yzytz17/1.5-joint-module/mechanical/cad-solidworks/universal_adapter.SLDPRT

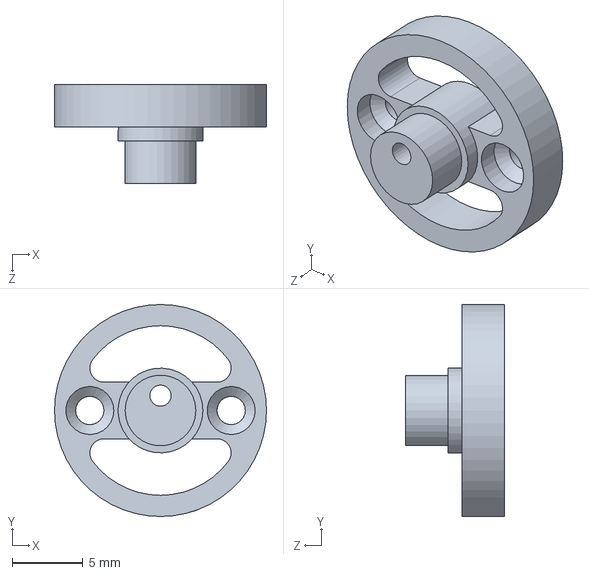
[picture p4: CAD file, 2026-11-02]
mechanical/cad-solidworks/universal_adapter.SLDPRT
15.0 x 15.0 x 7.00 mm
