yzytz17/1.5-joint-module/mechanical/stl/as-exported/crank_output_inst1.stl

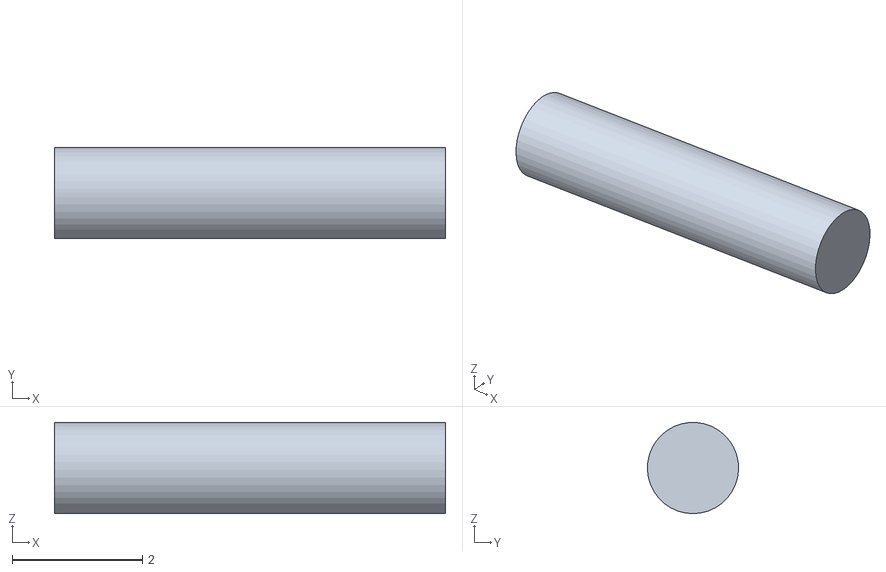
[picture p5: CAD file, 2026-11-02]
mechanical/stl/as-exported/crank_output_inst1.stl
6.00 x 1.40 x 1.40
