yzytz17/1.5-joint-module/mechanical/cad-solidworks/motor_1503_reference.SLDPRT

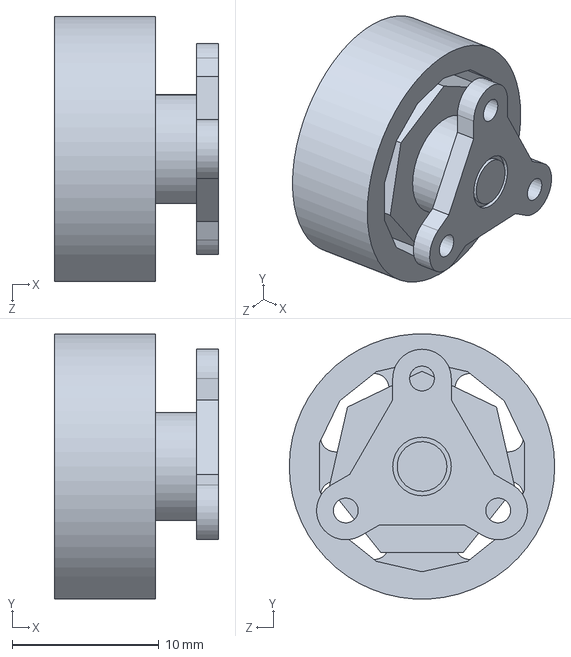
[picture p6: CAD file, 2026-11-02]
mechanical/cad-solidworks/motor_1503_reference.SLDPRT
11.2 x 18.1 x 18.1 mm
