yzytz17/1.5-joint-module/mechanical/stl/as-exported/part1_rod_inst4.stl

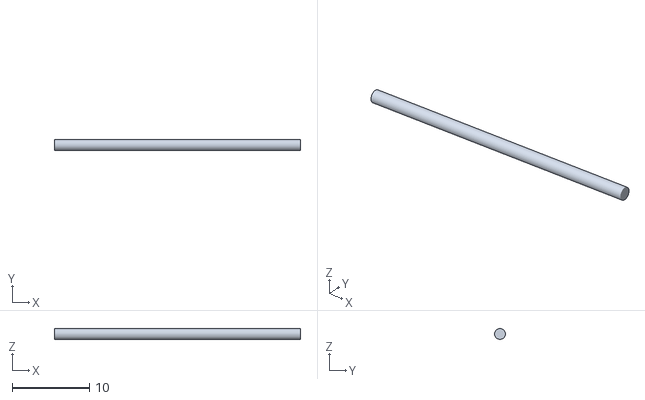
[picture p7: CAD file, 2026-11-02]
mechanical/stl/as-exported/part1_rod_inst4.stl
31.8 x 1.40 x 1.40
