yzytz17/1.5-joint-module/mechanical/cad-solidworks/external_ring_gear_flipped_m0.6_30T.SLDPRT

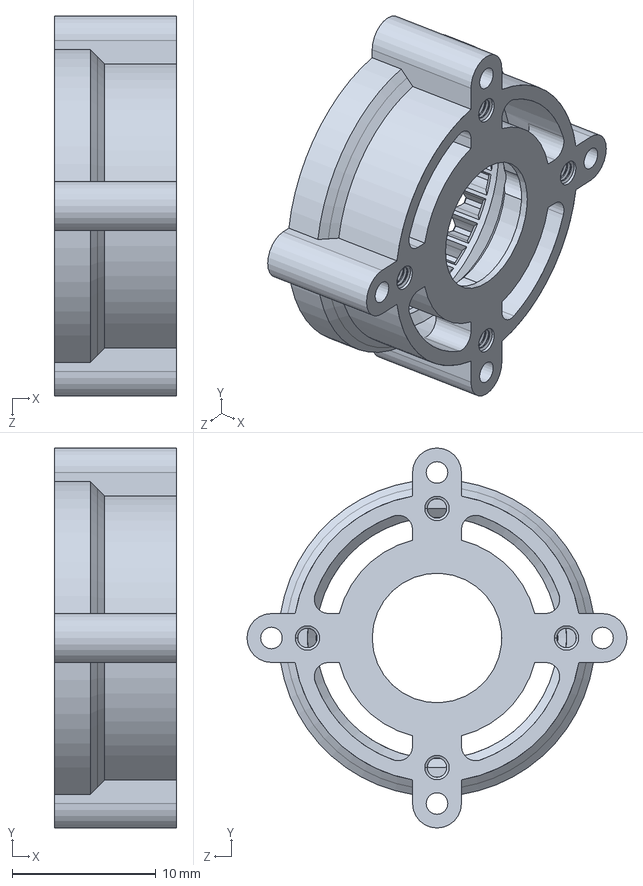
[picture p8: CAD file, 2026-11-02]
mechanical/cad-solidworks/external_ring_gear_flipped_m0.6_30T.SLDPRT
8.50 x 26.4 x 26.4 mm
