yzytz17/1.5-joint-module/mechanical/cad-solidworks/internal_ring_gear_m0.6_27T.SLDPRT

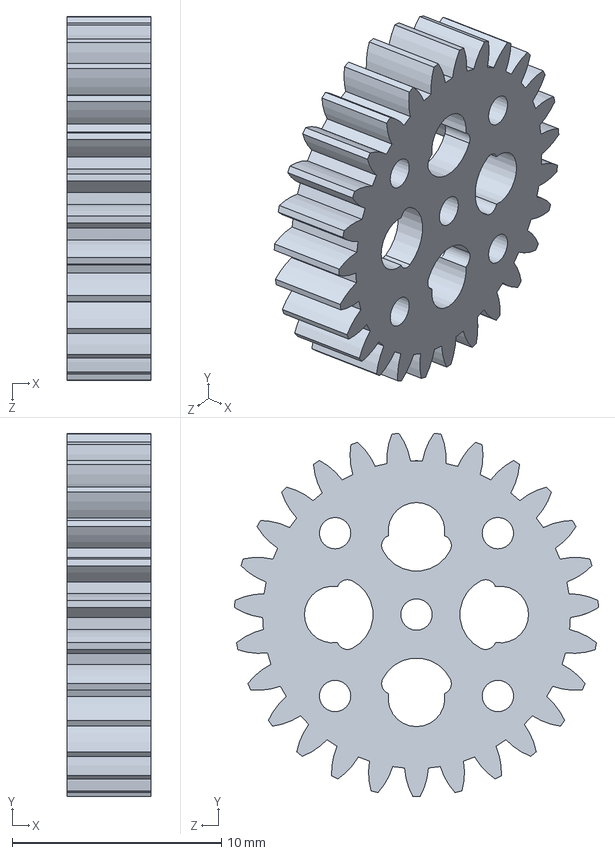
[picture p9: CAD file, 2026-11-02]
mechanical/cad-solidworks/internal_ring_gear_m0.6_27T.SLDPRT
4.00 x 17.4 x 17.4 mm
