yzytz17/1.5-joint-module/mechanical/stl/as-exported/motor_mount.stl

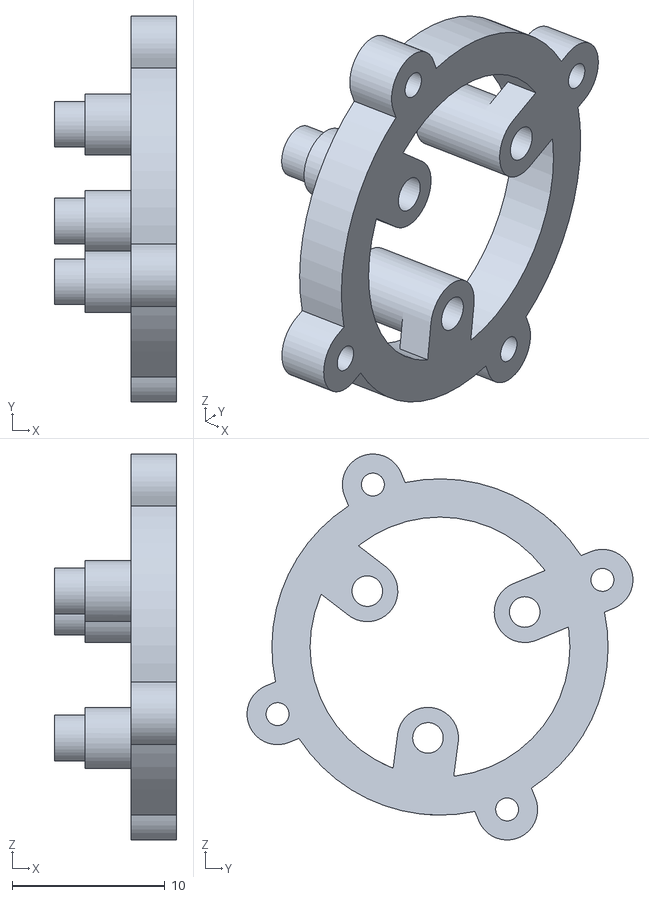
[picture p10: CAD file, 2026-11-02]
mechanical/stl/as-exported/motor_mount.stl
8.00 x 25.3 x 25.3
