yzytz17/1.5-joint-module/mechanical/cad-solidworks/mystery_intermediate_driver.SLDPRT

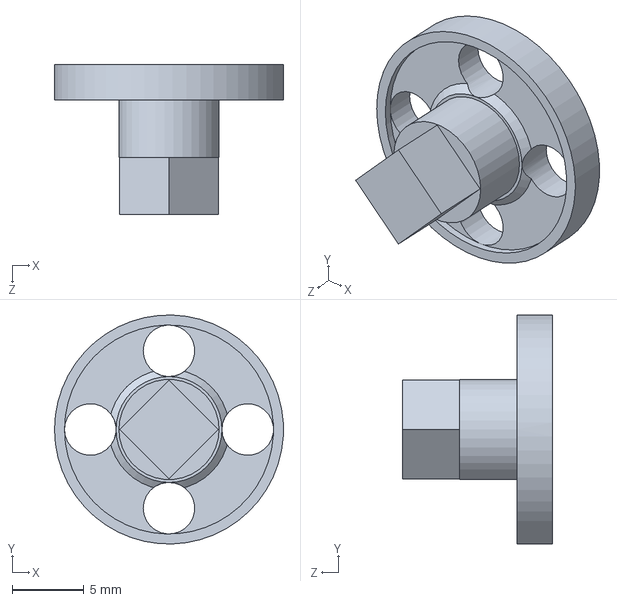
[picture p11: CAD file, 2026-11-02]
mechanical/cad-solidworks/mystery_intermediate_driver.SLDPRT
16.0 x 16.0 x 10.5 mm
