yzytz17/1.5-joint-module/mechanical/cad-solidworks/universal_adapter_extended.SLDPRT

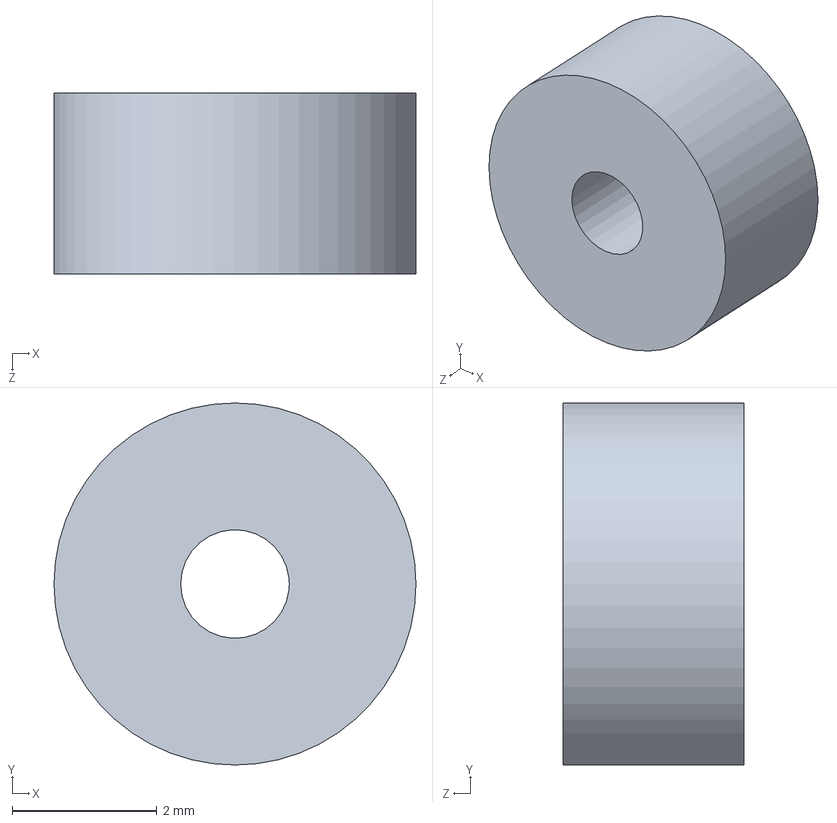
[picture p13: CAD file, 2026-11-02]
mechanical/cad-solidworks/universal_adapter_extended.SLDPRT
5.00 x 5.00 x 2.50 mm
