yzytz17/1.5-joint-module/mechanical/cad-solidworks/motor_mount.SLDPRT

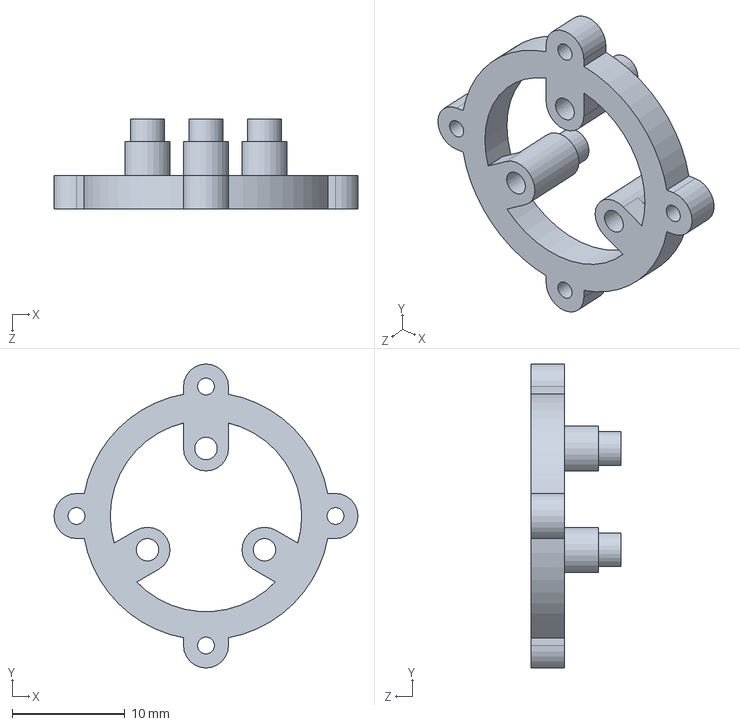
[picture p14: CAD file, 2026-11-02]
mechanical/cad-solidworks/motor_mount.SLDPRT
27.0 x 27.0 x 8.00 mm
