yzytz17/1.5-joint-module/mechanical/stl/as-exported/shaft_rocker_arm.stl

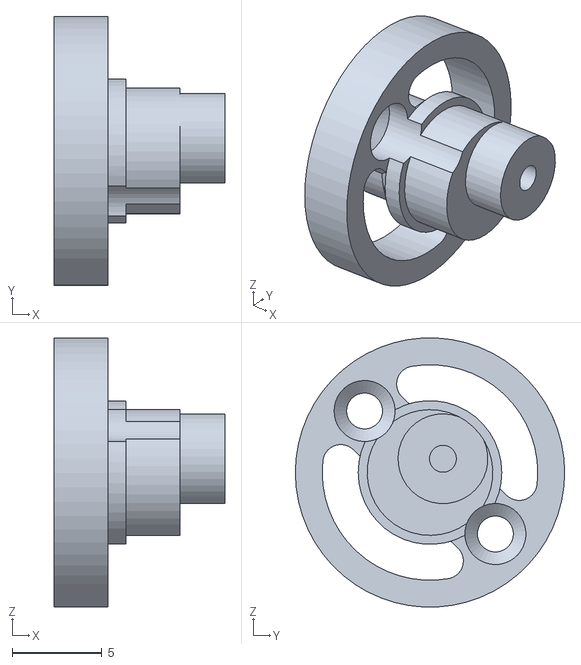
[picture p15: CAD file, 2026-11-02]
mechanical/stl/as-exported/shaft_rocker_arm.stl
9.50 x 15.0 x 15.0
