yzytz17/1.5-joint-module/mechanical/stl/as-exported/external_ring_gear_m0.6_30T.stl

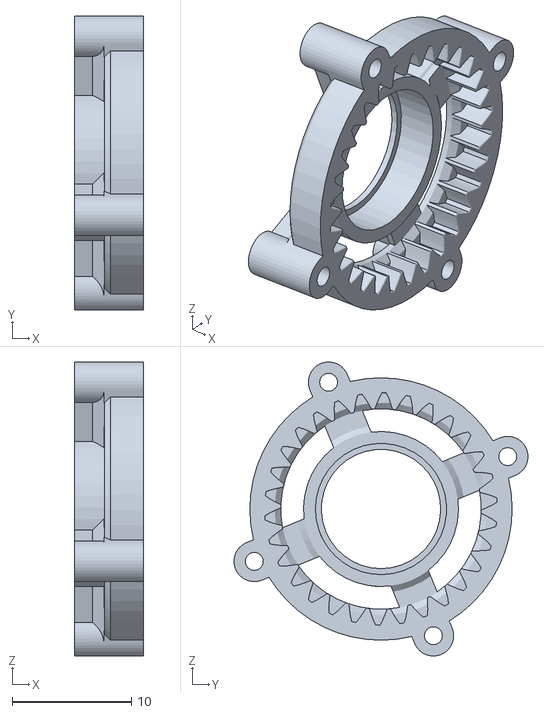
[picture p18: CAD file, 2026-11-02]
mechanical/stl/as-exported/external_ring_gear_m0.6_30T.stl
5.75 x 24.7 x 24.7
