yzytz17/1.5-joint-module/mechanical/cad-solidworks/gearbox_assembly.SLDASM

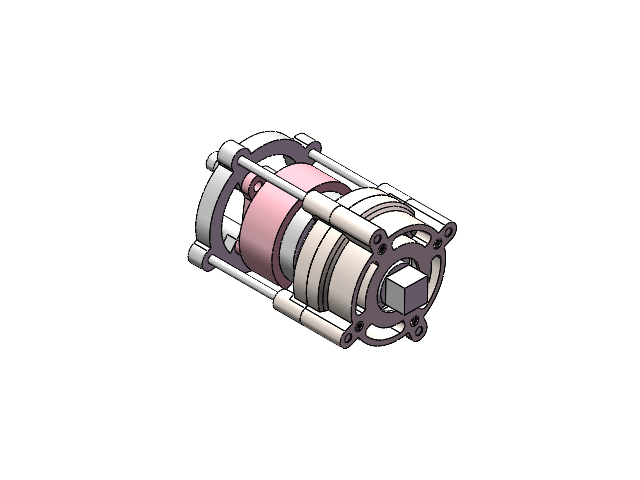
[picture p19: CAD file, 2026-11-02]
mechanical/cad-solidworks/gearbox_assembly.SLDASM
内齿圈0.6M 27T
外齿圈0.6M 30T
1503无刷电机 - 副本
电机座
外齿圈反面0.6M 30T
神秘中间传递
轴摇柄
零件1 x 4
类曲柄输出 x 4
