yzytz17/1.5-joint-module/(list of files, cad)

Other CAD files:
mechanical/stl/as-exported/motor_1503_reference.stl
mechanical/stl/as-exported/crank_output_inst2.stl
mechanical/cad-solidworks/crank_output.SLDPRT
mechanical/stl/as-exported/internal_ring_gear_m0.6_27T.stl
mechanical/cad-solidworks/part1_rod.SLDPRT
mechanical/stl/as-exported/part1_rod_inst3.stl
mechanical/stl/as-exported/crank_output_inst3.stl
mechanical/stl/as-exported/mystery_intermediate_driver.stl
mechanical/stl/as-exported/part1_rod_inst5.stl
mechanical/stl/as-exported/part1_rod_inst2.stl
mechanical/cad-solidworks/shaft_rocker_arm.SLDPRT
mechanical/stl/as-exported/crank_output_inst4.stl
mechanical/stl/print/internal_ring_gear_m0.6_27T.stl
mechanical/stl/print/motor_1503_reference.stl
mechanical/stl/print/mystery_intermediate_driver.stl
mechanical/stl/print/part1_rod.stl
