yzytz17/1.5-joint-module/(commit log)

2026-11-02 Initial release: $1.5 Joint Module
    Open-source robotic joint built from a 1503 brushless gimbal motor, a
    ~$1.5 four-layer FOC driver board that fits inside the motor bell, and a
    fully 3D-printed module-0.6 reduction gearbox.
    Reorganised from the author's original Chinese material set into an
    English-language repository:
    - firmware/openloop/ English translation of the ESP32-C3 + SimpleFOC
    open-loop drive, plus a reconstructed
    config.h.example (the original config.h was not
    released, so the firmware does not compile as-is)
    - firmware/openloop-zh/ original Chinese source, unmodified
    - hardware/pcb/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
    [Drill_PTH_Through.DRL, Drill_PTH_Through_Via.DRL, Gerber_BoardOutlineLayer.GKO, Gerber_BottomLayer.GBL, Gerber_BottomPasteMaskLayer.GBP, Gerber_BottomSilkscreenLayer.GBO, Gerber_BottomSolderMaskLayer.GBS, Gerber_TopLayer.GTL]
2026-11-02 Add sponsor page, README support sections and FUNDING.yml
    Adds a 'Support this project' section to both READMEs and a dedicated
    bilingual sponsor page under assets/sponsor/, rendering the author's
    original note (open source earns nothing; a tip of 10-20 yuan is welcome)
    in English and Chinese, anchored to the project's own $1.50 board price.
    .github/FUNDING.yml enables the Sponsor button pointing at the in-repo
    sponsor page. The native 'github:' key is deliberately left disabled:
    anyone can sponsor through GitHub Sponsors, but receiving a payout
    requires residence in a supported region, and GitHub's official list
    includes Hong Kong SAR and Macau SAR but not mainland China. Payouts run
    throu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
2026-11-02 Swap videos to NetDisk share; add driver-chip warning; drop donation infra
    Videos: the three intro MP4s (~100 MB) are not committed. Poster frames stay
    in assets/video/ and both READMEs link the author's Baidu NetDisk share
    (pwd ge5x). Committing 100 MB of video would tax every future clone for no
    benefit; a Release or the NetDisk mirror is the right home.
    Driver chip: added a prominent warning that the part is MP6540GU and NOT
    MP6540HGU. The two share an identical QFN-26 (5x5) footprint, so a wrong
    purchase solders down and still fails silently. Spec table (35V/3A/10A vs
    50V/5A/6A) plus the author's rationale: cheaper, the extra current is never
    used by a voltage-limited FOC drive, and wit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
2026-11-02 Add language policy, verbatim Chinese quotes, and serial-protocol warning
    Language policy: both READMEs now state that English is the public face,
    Chinese is the author's working language, and where a load-bearing statement
    exists in both the CHINESE ORIGINAL IS AUTHORITATIVE. Part numbers, pin
    numbers and measured dimensions are language-neutral and identical in both.
    Verbatim Chinese is now quoted alongside the translation for the two most
    load-bearing statements in docs/HARDWARE.md: the MP6540GU purchasing note
    (单片机一定采购MP 6540 GU) and the author's rationale for the non-H part
    (降低价格 / H版电流在FOC中无意义 / 电机KV太高, 高电流影响稳定性). Translati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
2026-11-02 Correct SolidWorks version: author toolchain is 2026, not 2025 SP3.0
    The 2025 SP3.0 reading came from the CAD walkthrough video's title bar, which
    only proves what that recording was made on. The author states their current
    toolchain is SolidWorks 2026.
    The exact saved-version of each committed .SLDPRT/.SLDASM could not be read
    from the bytes: the modern container is proprietary and encrypted (magic is
    neither the OLE D0CF11E0 signature nor a zip), so the version is only visible
    inside SolidWorks. Docs now say so plainly instead of asserting a version,
    keep the forward-compatibility warning (a file saved by a newer release
    cannot be opened by an older one), and push the STEP AP214 export as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
2026-11-02 Switch licence from MIT to CERN-OHL-W-2.0
    Author's choice (W over S): people may embed the joint in closed products
    while the joint design itself stays open and improving. Full CERN-OHL-W v2
    text installed as LICENSE; GitHub detects SPDX CERN-OHL-W-2.0.
    Plain-terms summary added to both READMEs: may study/copy/modify/make/sell;
    conveying the joint design or a modification requires publishing that design
    under the same licence; a larger product that only interfaces through the
    documented interface is External Material and may stay closed.
    Corrected an earlier wrong assumption: SimpleFOC (arduino-FOC) is MIT, not
    GPL-3.0 - verified against the upstream LICENSE via the GitHub API. So there
    is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
    [openloop.ino]
2026-11-02 Emphasise: angle sensor outputs PWM, read on the ADC, not I2C
    Author's clarification, now stated in the firmware header, the sensor class
    comment, config.h.example section 8, both READMEs (warning boxes), and
    docs/FIRMWARE.md / HARDWARE.md / BOM.md:
    The magnetic angle sensor reports the closed-loop angle as a PWM signal
    (duty cycle proportional to angle). It is read with the MCU's ADC on GPIO0.
    There is no I2C transaction anywhere in the firmware - do not wire SDA/SCL
    and do not look for an I2C address. This is called out as the most common
    wiring mistake with magnetic angle sensors, since their datasheets lead
    with I2C.
    Also explains the mechanism the code was already using: the 8-sample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
    [openloop.ino]
2026-11-02 Restore the video section to both READMEs (it was silently missing)
    Found during a pre-publish check: neither README contained the 'See it work'
    / '先看它跑起来' section, in any commit - the poster images were committed
    under assets/video/ and referenced from assets/README.md and the docs, but
    the README section that links them (and the Baidu NetDisk video share,
    pwd ge5x) was absent from both language versions.
    Re-added to both, placed right after the status note so it is the first
    substantive thing a visitor sees: three poster frames in a table, the
    NetDisk link with extraction code, and the two facts the videos establish
    (single-stage 10:1 reduction; ~2 yuan of printed plastic for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
2026-11-02 Add the three video poster frames (they were never actually committed)
    The pre-publish check found assets/video/ absent from both the working tree
    and every commit in history, while both READMEs and assets/README.md
    reference the posters. Re-copied from the author's source files and
    committed: 01-bench-demo-poster.jpg, 02-cad-walkthrough-10x-reduction-
    poster.jpg, 03-assembled-joint-in-hand-poster.jpg.
    These are the only still images of the project in the repository.
